Circuit-Stitch/TLV320ADC-breakout/pcbway/adc-breakout-bom.csv

Item | Designator | Qty | Manufacturer | Manufacturer Part Number | Description | Package | Type
1 | U1 | 1 | Texas Instruments | TLV320ADC6140IRTWR | 4-channel audio ADC | WQFN-24 4x4mm (RTW) | SMD
2 | U2 | 1 | Texas Instruments | TPS7A2033PDBVR | 3.3V 300mA low-noise LDO | SOT-23-5 | SMD
3 | Y1 | 1 | Abracon | ASTX-H11-24.576MHZ-T | 24.576MHz TCXO 2.5ppm | 3.2x2.5mm 4-pad | SMD
4 | FB1 | 1 | Murata | BLM18PG221SN1D | Ferrite bead 220R @ 100MHz | 0603 | SMD
5 | C1,C2,C11,C13 | 4 | Kyocera AVX | 06033C105KAT4A | 1uF 25V X7R | 0603 | SMD
6 | C3,C5,C7,C9 | 4 | Murata | GRM155R71C104KA88D | 100nF 16V X7R | 0402 | SMD
7 | C4,C6,C8,C10 | 4 | Murata | GRT188R61A106KE13D | 10uF 10V X5R | 0603 | SMD
8 | C12 | 1 | Murata | GRM155R71C103KA01D | 10nF 16V X7R | 0402 | SMD
9 | C14,C15,C16,C17,C18,C19,C20,C21 | 8 | Kyocera AVX | 0805ZC475KAT2A | 4.7uF 10V X7R | 0805 | SMD
10 | R1 | 1 | Yageo | RC0402FR-0710KL | 10k 1% | 0402 | SMD
11 | R2 | 1 | Yageo | RC0402FR-0722RL | 22R 1% | 0402 | SMD
12 | R3,R4,R5 | 3 | Yageo | RC0402FR-0733RL | 33R 1% | 0402 | SMD
13 | R6,R7 | 2 | Yageo | RC0402FR-074K7L | 4.7k 1% | 0402 | SMD
