Circuit-Stitch/TLV320ADC-breakout/jlcpcb/adc-breakout-bom.csv

Comment | Designator | Footprint | LCSC Part #
TLV320ADC6140IRTWR | U1 | WQFN-24_4x4mm | C1852020
TPS7A2033PDBVR | U2 | SOT-23-5 | C2862740
ASTX-H11-24.576MHZ-T | Y1 | Oscillator_3.2x2.5mm | C1987701
BLM18PG121SN1D 120R@100MHz | FB1 | 0603 | C14709
1uF 50V X5R | C1,C2,C11,C13 | 0603 | C15849
100nF 16V X7R | C3,C5,C7,C9 | 0402 | C1525
10uF 10V X5R | C4,C6,C8,C10 | 0603 | C19702
10nF 50V X7R | C12 | 0402 | C15195
4.7uF 25V X5R | C14,C15,C16,C17,C18,C19,C20,C21 | 0805 | C1779
10k 1% | R1 | 0402 | C25744
22R 1% | R2 | 0402 | C25092
33R 1% | R3,R4,R5 | 0402 | C25105
4.7k 1% | R6,R7 | 0402 | C25900
