Circuit-Stitch/TLV320ADC-breakout/renders/adc-breakout_rev1.step

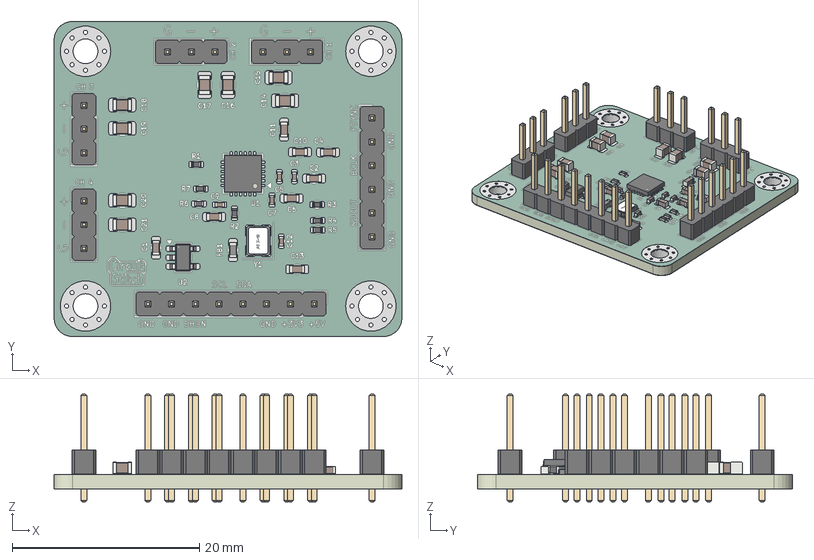
[picture p3: CAD file, 2026-11-13]
renders/adc-breakout_rev1.step
37.2 x 33.7 x 11.5 mm
R_0402_1005Metric x 7
C_0805_2012Metric x 8
PinHeader_1x06_P254mm_Vertical
C_0603_1608Metric x 8
PinHeader_1x08_P254mm_Vertical
C_0402_1005Metric x 5
Texas_RTW_WQFN-24-1EP_4x4mm_P0.5mm_EP2.7x2.7mm
SOT-23-5
PinHeader_1x03_P254mm_Vertical x 4
ASTX-H11
L_0603_1608Metric
adc-breakout-unsaved-export-gnjUz2_copper
adc-breakout-unsaved-export-gnjUz2_pad
adc-breakout-unsaved-export-gnjUz2_via
adc-breakout-unsaved-export-gnjUz2_silkscreen x 2
adc-breakout-unsaved-export-gnjUz2_soldermask x 2
adc-breakout-unsaved-export-gnjUz2_PCB
