Circuit-Stitch/TLV320ADC-breakout/adc-breakout.pdf

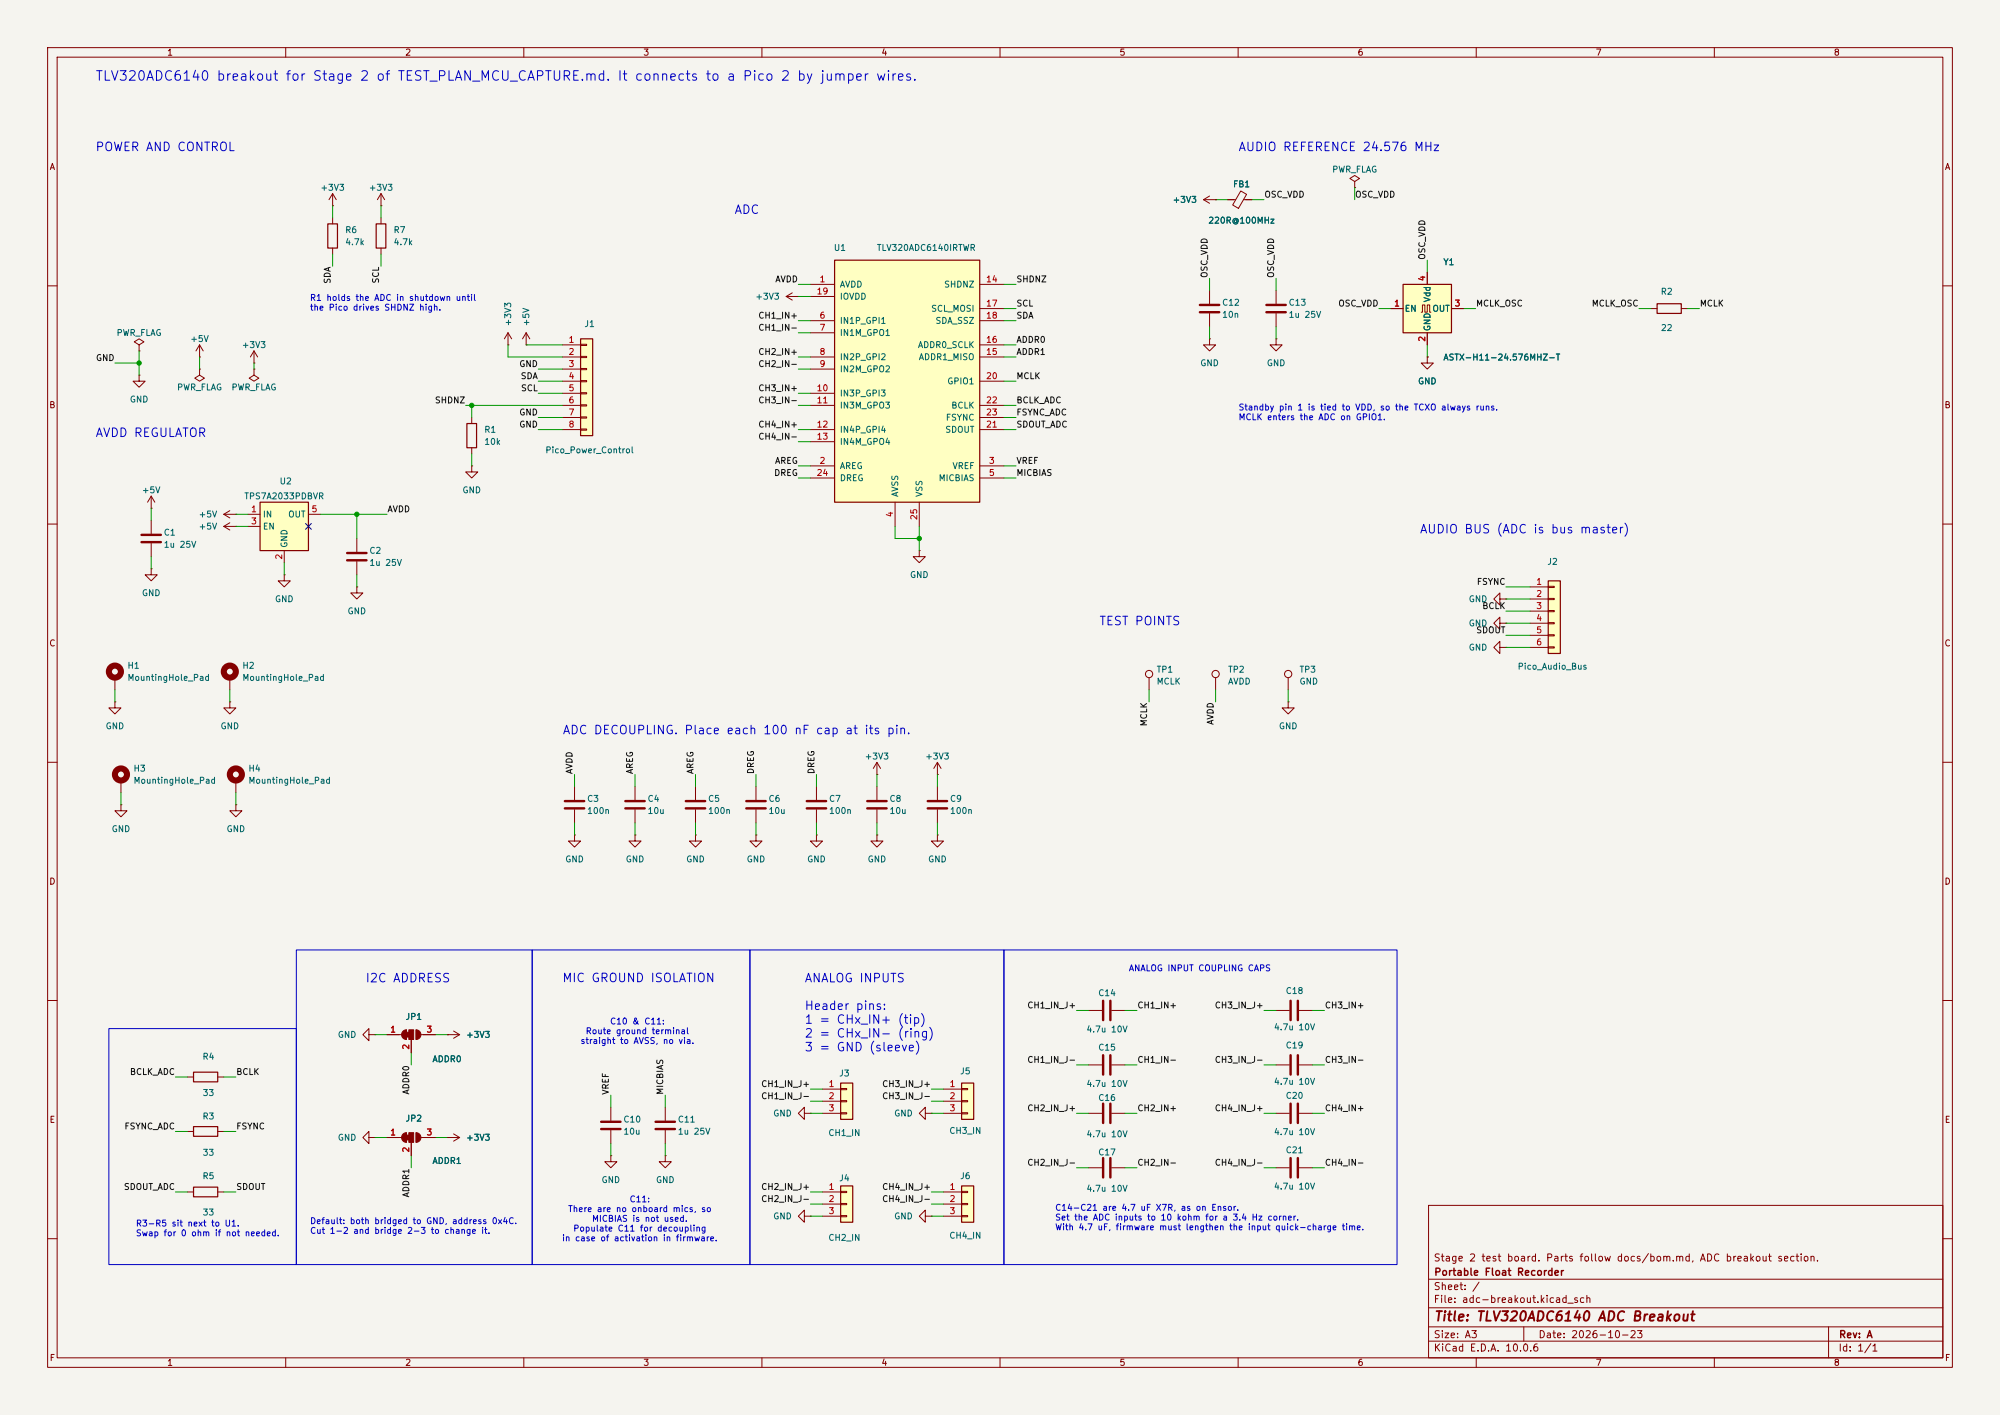
[picture p4: page 1]

Standby pin 1 is tied to VDD, so the TCXO always runs. MCLK enters the ADC on GPIO1. TLV320ADC6140 breakout for Stage 2 of TEST_PLAN_MCU_CAPTURE.md. It connects to a Pico 2 by jumper wires.

R1 holds the ADC in shutdown until the Pico drives SHDNZ high.

AUDIO BUS (ADC is bus master)

ADC DECOUPLING. Place each 100 nF cap at its pin.

ANALOG INPUT COUPLING CAPS

C11: There are no onboard mics, so MICBIAS is not used. Populate C11 for decoupling

C14-C21 are 4.7 uF X7R, as on Ensor. Set the ADC inputs to 10 kohm for a 3.4 Hz corner. With 4.7 uF, firmware must lengthen the input quick-charge time.

Default: both bridged to GND, address 0x4C. Cut 1-2 and bridge 2-3 to change it. R3-R5 sit next to U1. Swap for 0 ohm if not needed.

Stage 2 test board. Parts follow docs/bom.md, ADC breakout section.
Portable Float Recorder
Sheet: /
File: adc-breakout.kicad_sch
Title: TLV320ADC6140 ADC Breakout

Size: A3 | Rev: A | F Date: 2026-10-23
KiCad E.D.A. 10.0.6 | Id: 1/1
