Circuit-Stitch/TLV320ADC-breakout/adc-breakout.kicad_pcb

## KiCad design adc-breakout.kicad_pcb (2026-11-01)

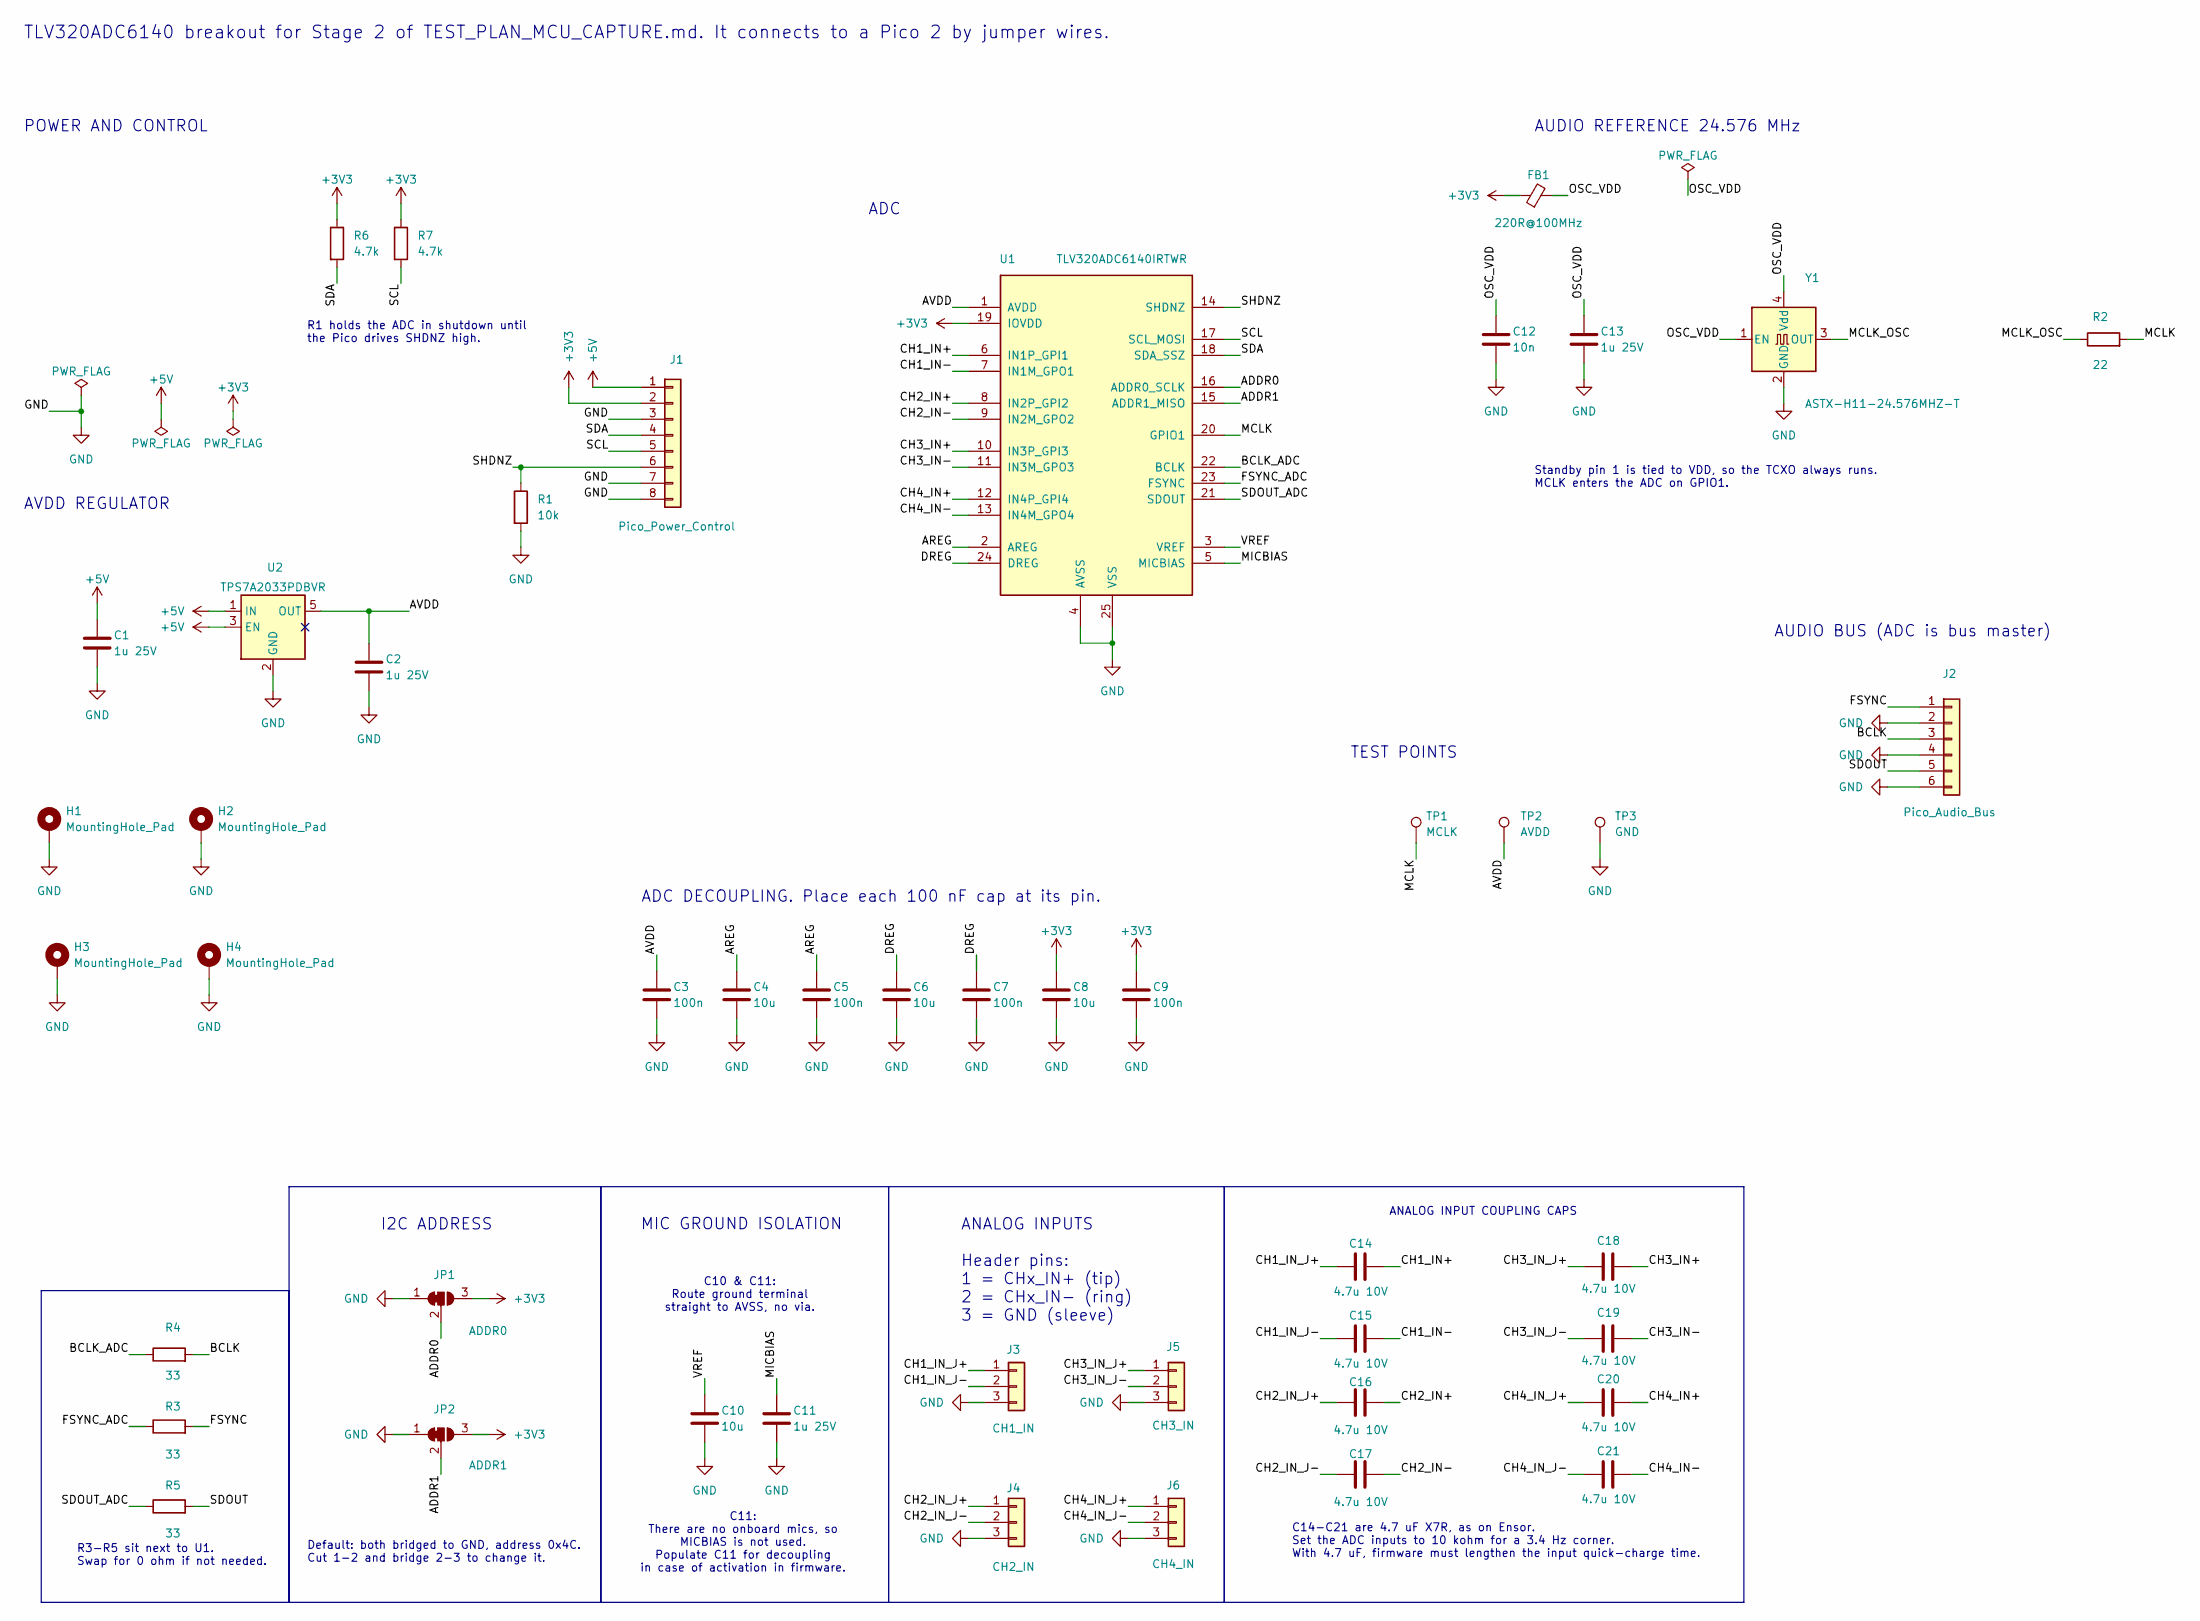
[picture p5: schematic adc-breakout.kicad_sch, TLV320ADC6140 ADC Breakout]

Parts:
C1, C2, C11, C13: 1u 25V; C_0603_1608Metric; MPN Kyocera AVX 06033C105KAT4A
C3, C5, C7, C9: 100n; C_0402_1005Metric; MPN Murata GRM155R71C104KA88D
C4, C6, C8, C10: 10u; C_0603_1608Metric; MPN Murata GRT188R61A106KE13D
C12: 10n; C_0402_1005Metric; MPN Murata GRM155R71C103KA01D
C14, C15, C16, C17, C18, C19, C20, C21: 4.7u 10V; C_0805_2012Metric; MPN Kyocera AVX 0805ZC475KAT2A
FB1: 220R@100MHz; L_0603_1608Metric; MPN Murata BLM18PG221SN1D
H1, H2, H3, H4: MountingHole_Pad; MountingHole_2.7mm_M2.5_Pad_Via
J1: Pico_Power_Control; PinHeader_1x08_P2.54mm_Vertical
J2: Pico_Audio_Bus; PinHeader_1x06_P2.54mm_Vertical
J3: CH1_IN; PinHeader_1x03_P2.54mm_Vertical
J4: CH2_IN; PinHeader_1x03_P2.54mm_Vertical
J5: CH3_IN; PinHeader_1x03_P2.54mm_Vertical
J6: CH4_IN; PinHeader_1x03_P2.54mm_Vertical
JP1: ADDR0; SolderJumper-3_P1.3mm_Bridged12_RoundedPad1.0x1.5mm
JP2: ADDR1; SolderJumper-3_P1.3mm_Bridged12_RoundedPad1.0x1.5mm
R1: 10k; R_0402_1005Metric; MPN Yageo RC0402FR-0710KL
R2: 22; R_0402_1005Metric; MPN Yageo RC0402FR-0722RL
R3, R4, R5: 33; R_0402_1005Metric; MPN Yageo RC0402FR-0733RL
R6, R7: 4.7k; R_0402_1005Metric; MPN Yageo RC0402FR-074K7L
TP1: MCLK; TestPoint_Pad_D1.5mm
TP2: AVDD; TestPoint_Pad_D1.5mm
TP3: GND; TestPoint_Pad_D1.5mm
U1: TLV320ADC6140IRTWR; Texas_RTW_WQFN-24-1EP_4x4mm_P0.5mm_EP2.7x2.7mm_ThermalVias
U2: TPS7A2033PDBVR; SOT-23-5
Y1: ASTX-H11-24.576MHZ-T; Oscillator_SMD_Abracon_ASE-4Pin_3.2x2.5mm; MPN Abracon ASTX-H11-24.576MHZ-T

Connections:
+3V3: C8.1, C9.1, FB1.1, J1.2, JP1.3 (B), JP2.3 (B), R6.1, R7.1, U1.19 (IOVDD)
+5V: C1.1, J1.1, U2.1 (IN), U2.3 (EN)
/ADDR0: JP1.2 (C), U1.16 (ADDR0_SCLK)
/ADDR1: JP2.2 (C), U1.15 (ADDR1_MISO)
/AREG: C4.1, C5.1, U1.2 (AREG)
/AVDD: C2.1, C3.1, TP2.1 (1_1), U1.1 (AVDD), U2.5 (OUT)
/BCLK: J2.3, R4.2
/BCLK_ADC: R4.1, U1.22 (BCLK)
/CH1_IN+: C14.2, U1.6 (IN1P_GPI1)
/CH1_IN-: C15.2, U1.7 (IN1M_GPO1)
/CH1_IN_J+: C14.1, J3.1
/CH1_IN_J-: C15.1, J3.2
/CH2_IN+: C16.2, U1.8 (IN2P_GPI2)
/CH2_IN-: C17.2, U1.9 (IN2M_GPO2)
/CH2_IN_J+: C16.1, J4.1
/CH2_IN_J-: C17.1, J4.2
/CH3_IN+: C18.2, U1.10 (IN3P_GPI3)
/CH3_IN-: C19.2, U1.11 (IN3M_GPO3)
/CH3_IN_J+: C18.1, J5.1
/CH3_IN_J-: C19.1, J5.2
/CH4_IN+: C20.2, U1.12 (IN4P_GPI4)
/CH4_IN-: C21.2, U1.13 (IN4M_GPO4)
/CH4_IN_J+: C20.1, J6.1
/CH4_IN_J-: C21.1, J6.2
/DREG: C6.1, C7.1, U1.24 (DREG)
/FSYNC: J2.1, R3.2
/FSYNC_ADC: R3.1, U1.23 (FSYNC)
/MCLK: R2.2, TP1.1 (1_1), U1.20 (GPIO1)
/MCLK_OSC: R2.1, Y1.3 (OUT)
/MICBIAS: C11.1, U1.5 (MICBIAS)
/OSC_VDD: C12.1, C13.1, FB1.2, Y1.1 (EN), Y1.4 (Vdd)
/SCL: J1.5, R7.2, U1.17 (SCL_MOSI)
/SDA: J1.4, R6.2, U1.18 (SDA_SSZ)
/SDOUT: J2.5, R5.2
/SDOUT_ADC: R5.1, U1.21 (SDOUT)
/SHDNZ: J1.6, R1.1, U1.14 (SHDNZ)
/VREF: C10.1, U1.3 (VREF)
GND: C1.2, C2.2, C3.2, C4.2, C5.2, C6.2, C7.2, C8.2, C9.2, C10.2, C11.2, C12.2, C13.2, H1.1 (1_1), H2.1 (1_1), H3.1 (1_1), H4.1 (1_1), J1.3, J1.7, J1.8, J2.2, J2.4, J2.6, J3.3, J4.3, J5.3, J6.3, JP1.1 (A), JP2.1 (A), R1.2, TP3.1 (1_1), U1.4 (AVSS), U1.25 (VSS), U2.2 (GND), Y1.2 (GND)

Notes on the sheet:
Standby pin 1 is tied to VDD, so the TCXO always runs. MCLK enters the ADC on GPIO1.
C11: There are no onboard mics, so MICBIAS is not used. Populate C11 for decoupling in case of activation in firmware.
TLV320ADC6140 breakout for Stage 2 of TEST_PLAN_MCU_CAPTURE.md. It connects to a Pico 2 by jumper wires.
MIC GROUND ISOLATION
AUDIO BUS (ADC is bus master)
TEST POINTS
R1 holds the ADC in shutdown until the Pico drives SHDNZ high.
ANALOG INPUT COUPLING CAPS
Default: both bridged to GND, address 0x4C. Cut 1-2 and bridge 2-3 to change it.
R3-R5 sit next to U1. Swap for 0 ohm if not needed.
ADC DECOUPLING. Place each 100 nF cap at its pin.
C10 & C11: Route ground terminal straight to AVSS, no via.
C14-C21 are 4.7 uF X7R, as on Ensor. Set the ADC inputs to 10 kohm for a 3.4 Hz corner. With 4.7 uF, firmware must lengthen the input quick-charge time.
I2C ADDRESS
POWER AND CONTROL
AUDIO REFERENCE 24.576 MHz
ADC
ANALOG INPUTS Header pins: 1 = CHx_IN+ (tip) 2 = CHx_IN- (ring) 3 = GND (sleeve)
AVDD REGULATOR

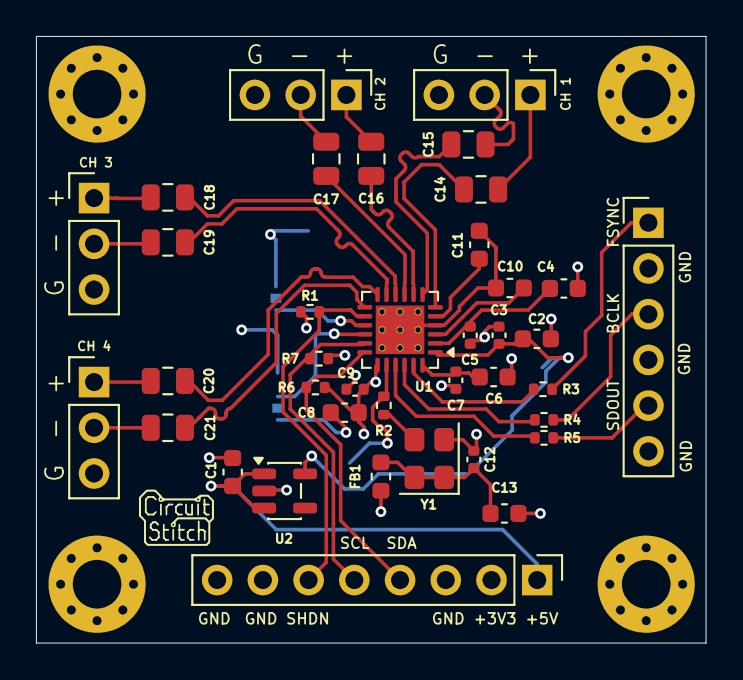
[picture p6: board adc-breakout.kicad_pcb from above]

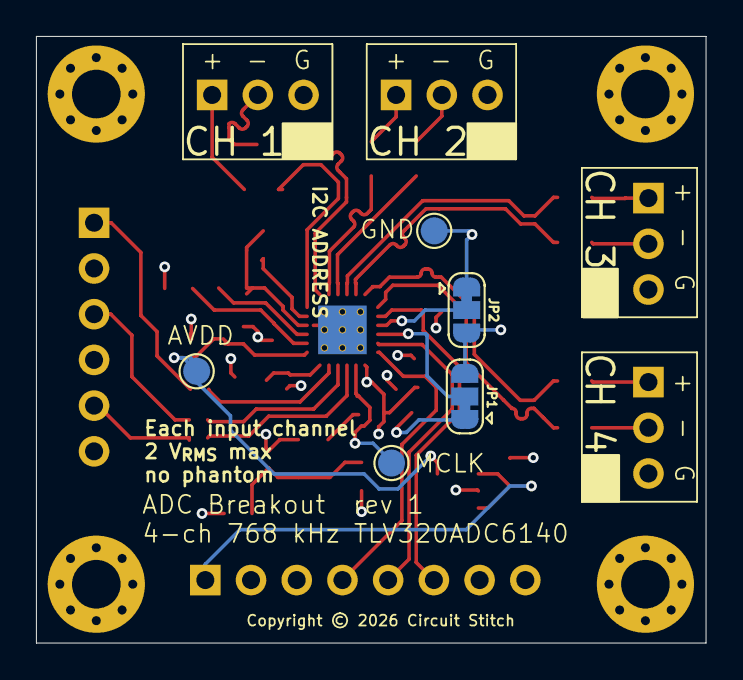
[picture p7: board adc-breakout.kicad_pcb from below]

Board: 4 copper layers, 37.2 x 33.7 mm, 47 parts (5 on the bottom side), 38 nets.
