Circuit-Stitch/TLV320ADC-breakout/(commit log)

2026-10-23 Add the ADC breakout KiCad project
    The ADC breakout is the Stage 2 test board. It carries the TLV320ADC6140,
    the TPS7A2033 AVDD regulator, and the 24.576 MHz TCXO. Headers connect it
    to a Pico 2 by jumper wires. Parts and reference designators follow the
    ADC breakout section of docs/bom.md.
    J3-J6 are balanced line inputs CH1-CH4, wired to the ADC through the
    coupling caps. Each input net pair ends in +/- so the PCB editor routes
    it as a differential pair.
    Two changes from the BOM:
    - C10 and C11 ground to a separate AVSS net. Net tie NT1 joins AVSS to
    GND at U1 pin 4. This keeps the VREF and MICBIAS cap grounds off the
    plane.
    - JP1 and JP2 are 3-pad jumpers, bridged to GND by default.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
    [adc-breakout.kicad_sch]
2026-10-23 Tidy the ADC breakout schematic and start the PCB
    [adc-breakout.kicad_pcb, adc-breakout.kicad_sch]
2026-10-23 Match the docs to the new J2 pin order
2026-10-23 Regenerate the ADC breakout schematic PDF
2026-10-23 Fix DRC errors on the ADC breakout PCB
    NT1 now sits between U1 pin 4 and the thermal pad. It uses the
    0.25 mm net tie footprint, and the schematic matches.
    Vias no longer sit on SMD pads. Each one moves off its pad.
    The top board edge moves up 0.1 mm. H1 and H2 now clear it by 0.5 mm.
    The board rules now allow 0.2 mm holes, 0.2 mm hole clearance, and
    0.15 mm copper clearance. U1's thermal vias use 0.2 mm drills.
    Other fixes: TP2 clears the C6 via, C5 clears the VREF and AREG
    tracks, and a dangling SCL stub is gone.
    DRC now reports no errors. The 34 remaining warnings are reference
    text below the 0.8 mm silkscreen minimum.
    [adc-breakout.kicad_pcb, adc-breakout.kicad_sch]
2026-10-24 Add silkscreen labels and JLCPCB order files for ADC breakout rev 1
    The silkscreen now labels every header pin and each input channel. The
    back carries the board name, revision, I2C address table, test point
    names, and a line-level warning: 2 Vrms max, no phantom power.
    jlcpcb/ holds the assembly BOM and placement file. The BOM uses JLC
    Basic parts for every passive, so only U1, U2, and Y1 pay the Extended
    part fee. The passives differ from docs/bom.md: X5R in place of X7R on
    the 1 uF and 4.7 uF caps, and a 120 ohm bead in place of 220 ohm on FB1.
    gerbers/version 1 is the gerber and drill set for the rev 1 order.
    [adc-breakout-B_Cu.gbr, adc-breakout-B_Mask.gbr, adc-breakout-B_Paste.gbr, adc-breakout-B_Silkscreen.gbr, adc-breakout-Edge_Cuts.gbr, adc-breakout-F_Cu.gbr, adc-breakout-F_Mask.gbr, adc-breakout-F_Paste.gbr]
2026-11-01 Make the ADC breakout a standalone project
    The board moved out of the portable-float-recorder repo. The README
    now describes the board on its own. The BOM and the ADC datasheet
    moved here with it.
2026-11-01 Remove the AVSS net tie
    The net tie is not needed. C10 and C11 now ground to GND, and their
    ground terminals route straight to U1 pin 4. The routing is simpler.
    The project adds 0.2 mm and 0.3 mm track widths.
    [adc-breakout.kicad_pcb, adc-breakout.kicad_sch]
2026-11-01 Link to the portacorder repo
    The breakout now lives in its own repo. README.md and docs/bom.md link
    back to portacorder on GitHub.
2026-11-01 Move the oscillator selection notes here from portacorder
    docs/oscillator-selection.md and its 4 datasheets now live in this repo.
    docs/bom.md links to the notes locally. README.md lists them.
2026-11-01 Regenerate the schematic PDF without the AVSS net tie
2026-11-01 Add board renders and the Y1 3D model
    Embed the ASTX-H11 STEP model in the PCB for Y1. It replaces the
    stock Abracon ASE model. The footprint and copper are unchanged.
    The Y1 silkscreen reference is thinner, 0.125 mm instead of 0.15 mm.
    Add front and back renders in images/ and show them in the README.
    Add the ASTX-H11 datasheet and list it in the README.
    [adc-breakout.kicad_pcb]
2026-11-13 Add PCBWay assembly files and record rev 1 as built
    The PCBWay BOM uses manufacturer part numbers from docs/bom.md. The
    centroid file is exported from the current PCB and covers the same 32
    SMD parts as the JLCPCB CPL.
    Rev 1 was assembled by JLCPCB with a 120 ohm FB1 and 50 V X5R 1 uF
    caps. docs/bom.md now records this.
    [adc-breakout-bom.csv, adc-breakout-centroid.csv]
2026-11-13 Move board renders to renders/ and add the STEP model
    [adc-breakout_rev1.step]
2026-11-13 Link to the PCBWay shared project
2026-11-13 Export the STEP model to renders/
    KiCad's STEP export now writes renders/adc-breakout_rev1.step, the
    model committed with the board renders.
