Circuit-Stitch/TLV320ADC-breakout/(notices)

Notices in the files:
adc-breakout.kicad_pcb:
Copyright © 2026 Circuit Stitch
